markuskunej/The-Echo-Belt/README.md

# The_Echo_Belt
A mobility aid I created for the visually impaired. It is a belt with 6 ultrasonic sensors and vibration motors which alert the wearer of obstacles around them using haptic feedback. Check out an article about the project at https://www.brantfordexpositor.ca/2018/05/30/student-wins-gold-at-national-science-fair and the regional fair page for the project at https://www.basef.ca/fair/project-view.php?ProjectID=9328
